htlabnet/Arduino_DRSSTC_Interrupter_For_v1/README.md

# HTLAB.NET Arduino DRSSTC Interrupter

https://htlab.net/electronics/teslacoil/arduino-drsstc-interrupter/
