htlabnet/Arduino_DRSSTC_Interrupter_For_v1/(list of files, cad)

Other CAD files:
Design/Arduino_Interrupter_v1_Design.dwg
Design/Arduino_Interrupter_v1_TD10-15-4_Connector_MIDI_USB.dwg
Design/TD10-15-4.dxf
Design/Arduino_Interrupter_v1_TD10-15-4_Top.dwg
Design/Arduino_Interrupter_v1_TD10-15-4_Connector_BNC.dwg
Design/TD10-15-4.dwg
