htlabnet/Arduino_DRSSTC_Interrupter_For_v1/Document/Arduino_DRSSTC_Interrupter_Ver1.0_Schematic.pdf

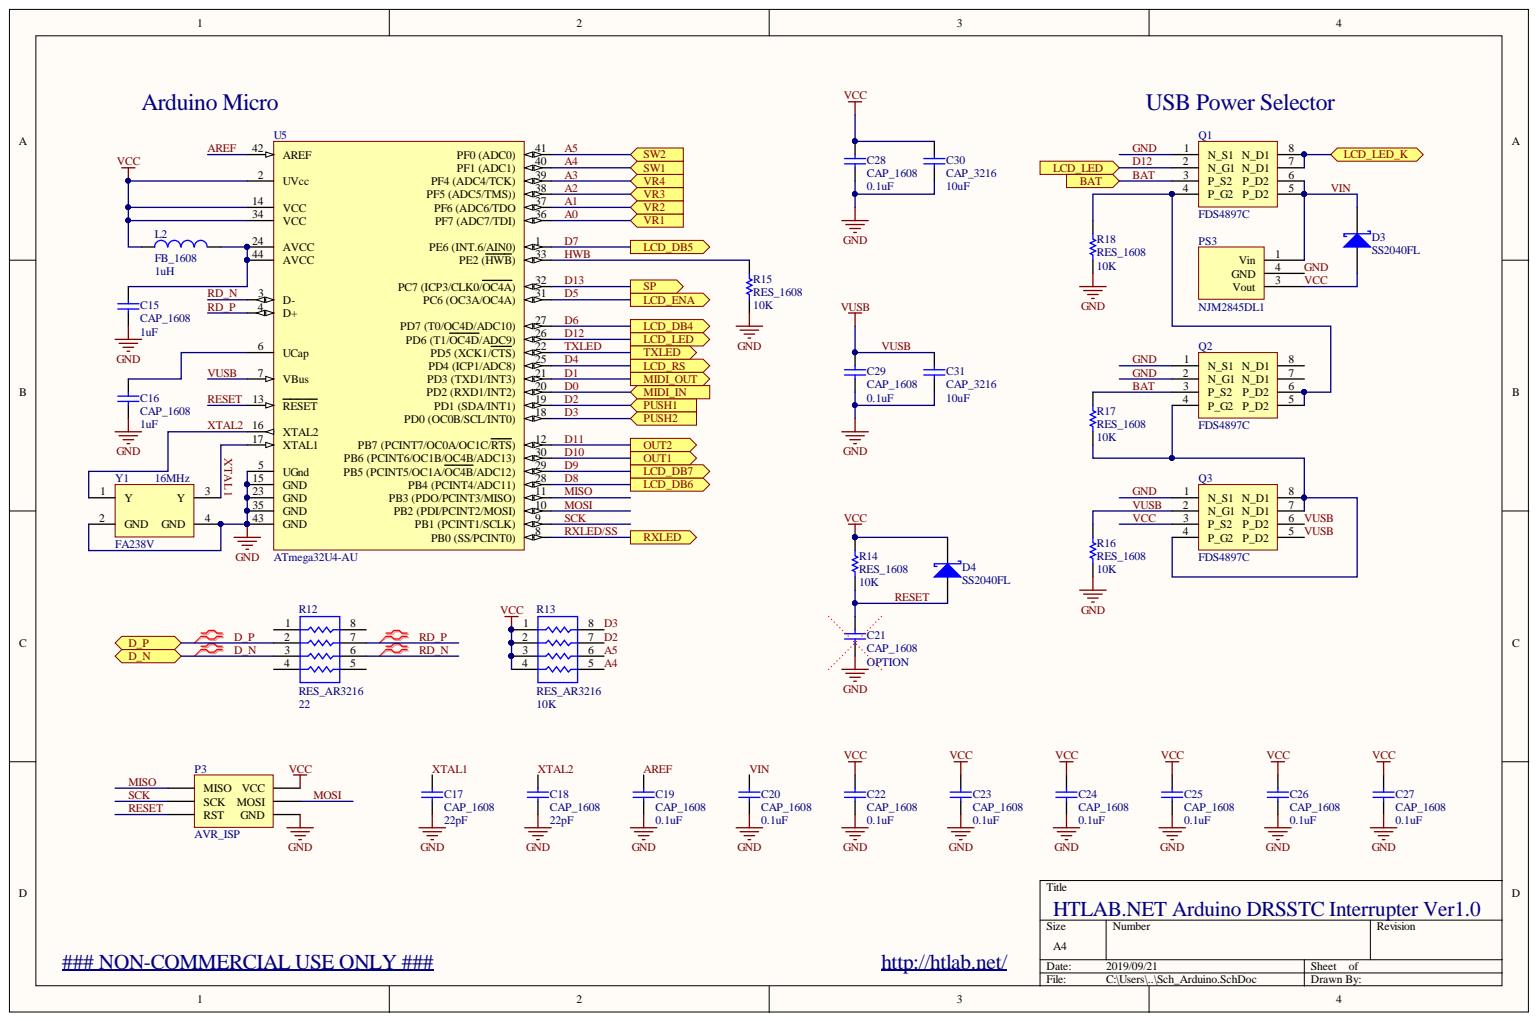
[picture p35: page 1]

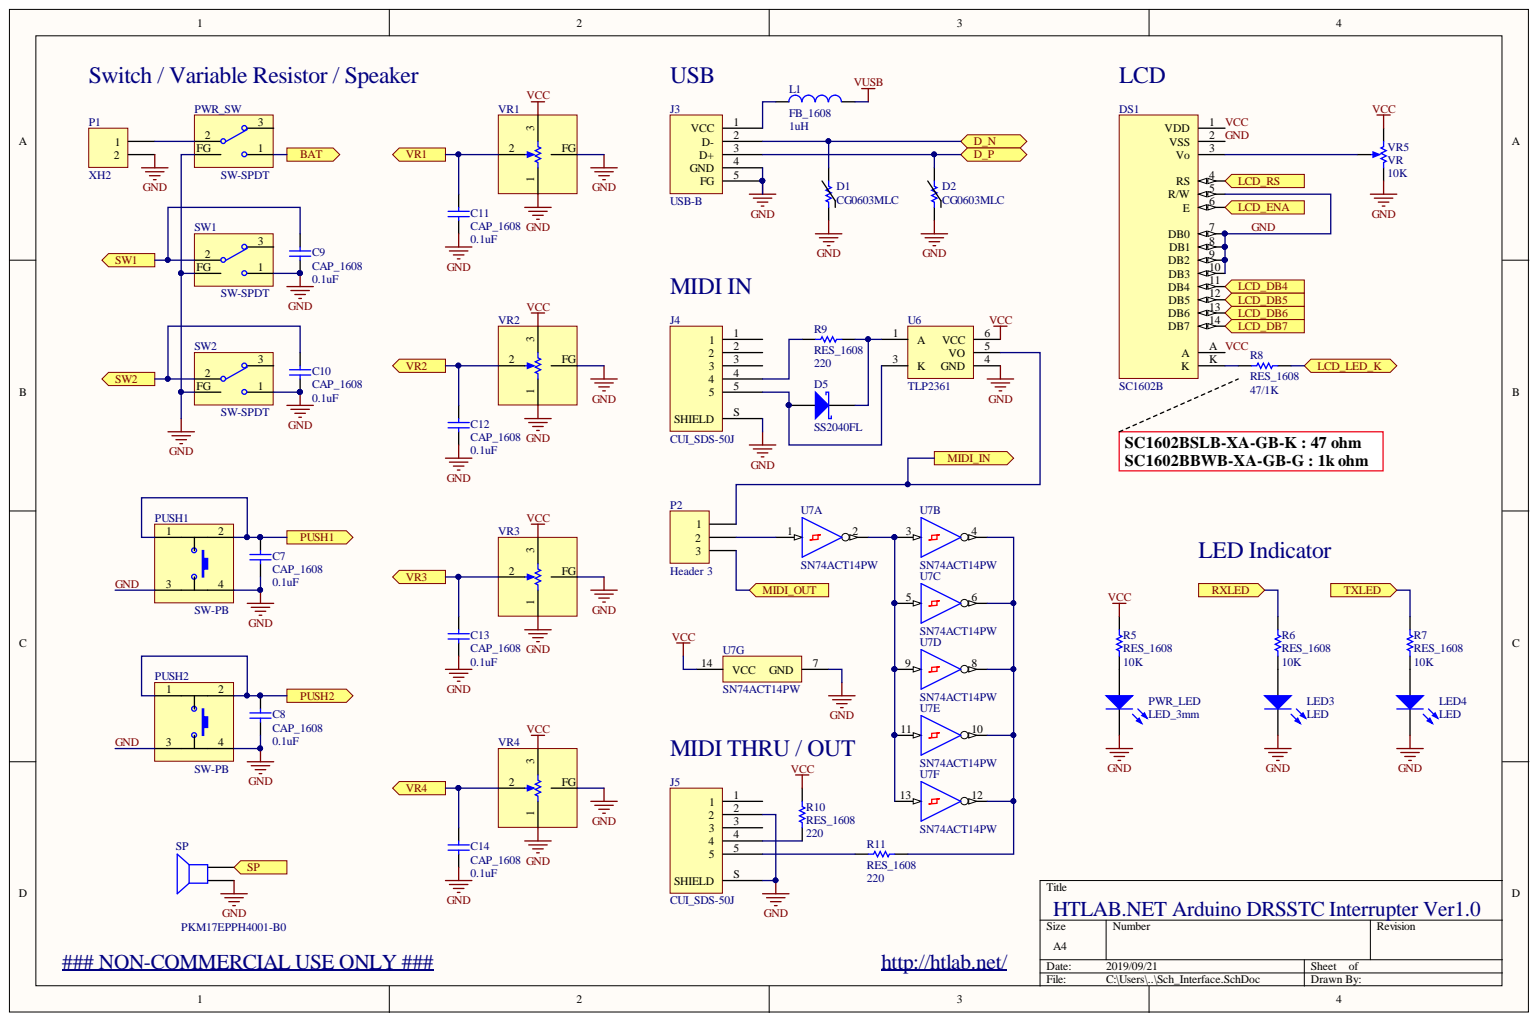
[picture p36: page 2]

GND GND

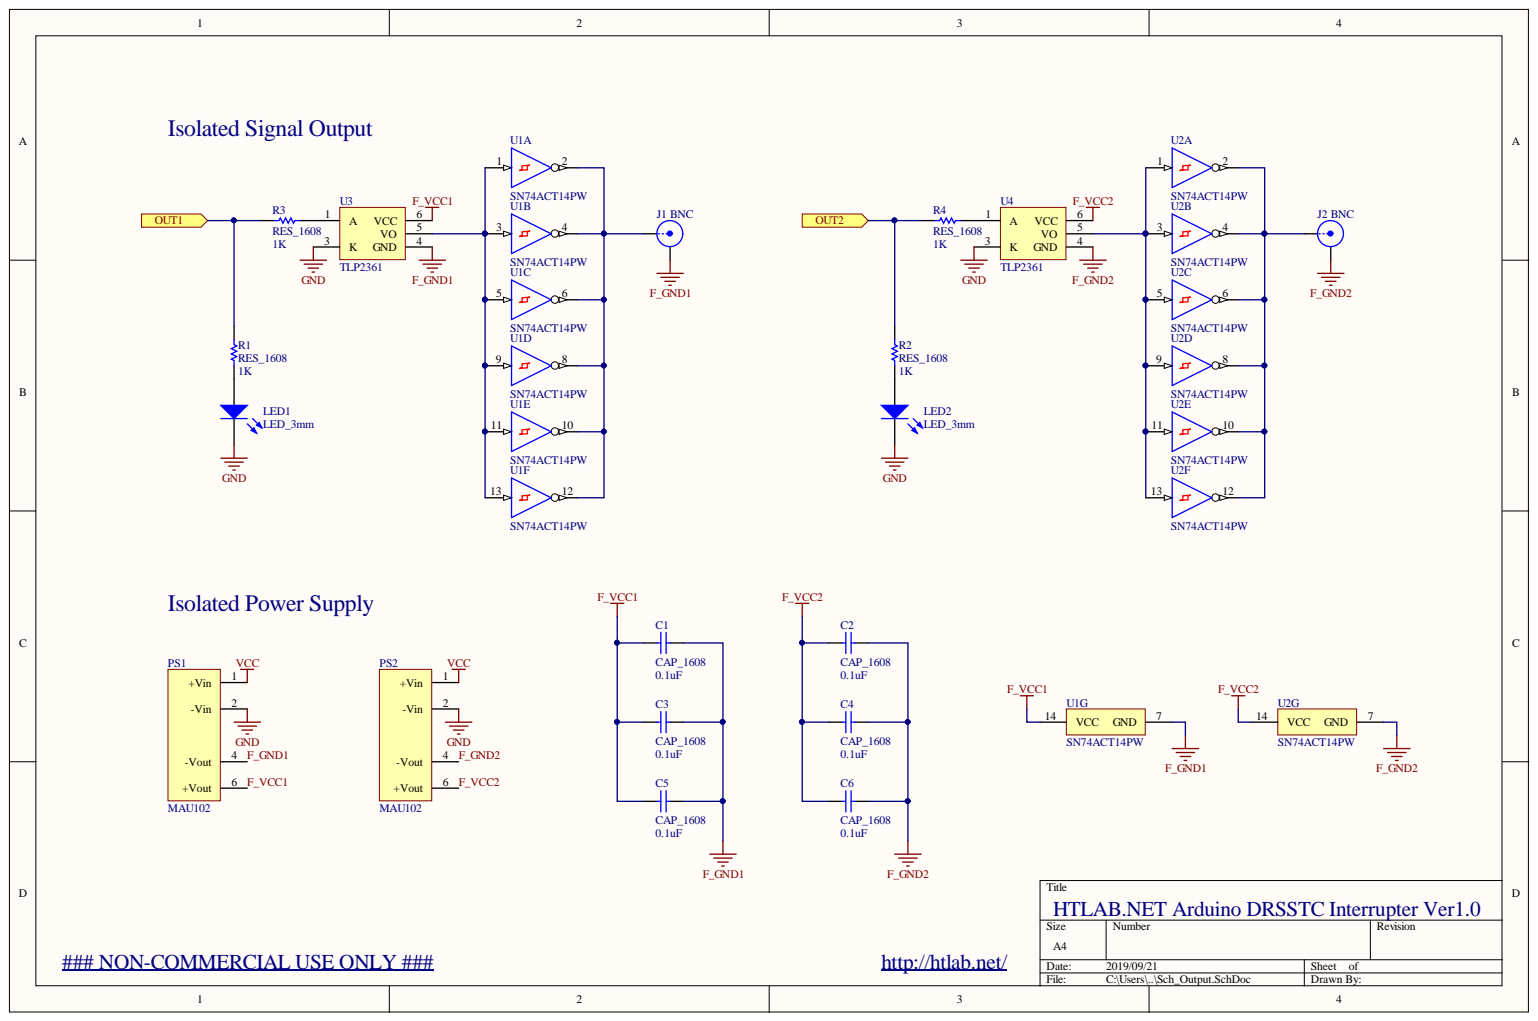
[picture p37: page 3]

Title
HTLAB.NET Arduino DRSSTC Interrupter Ver1.0

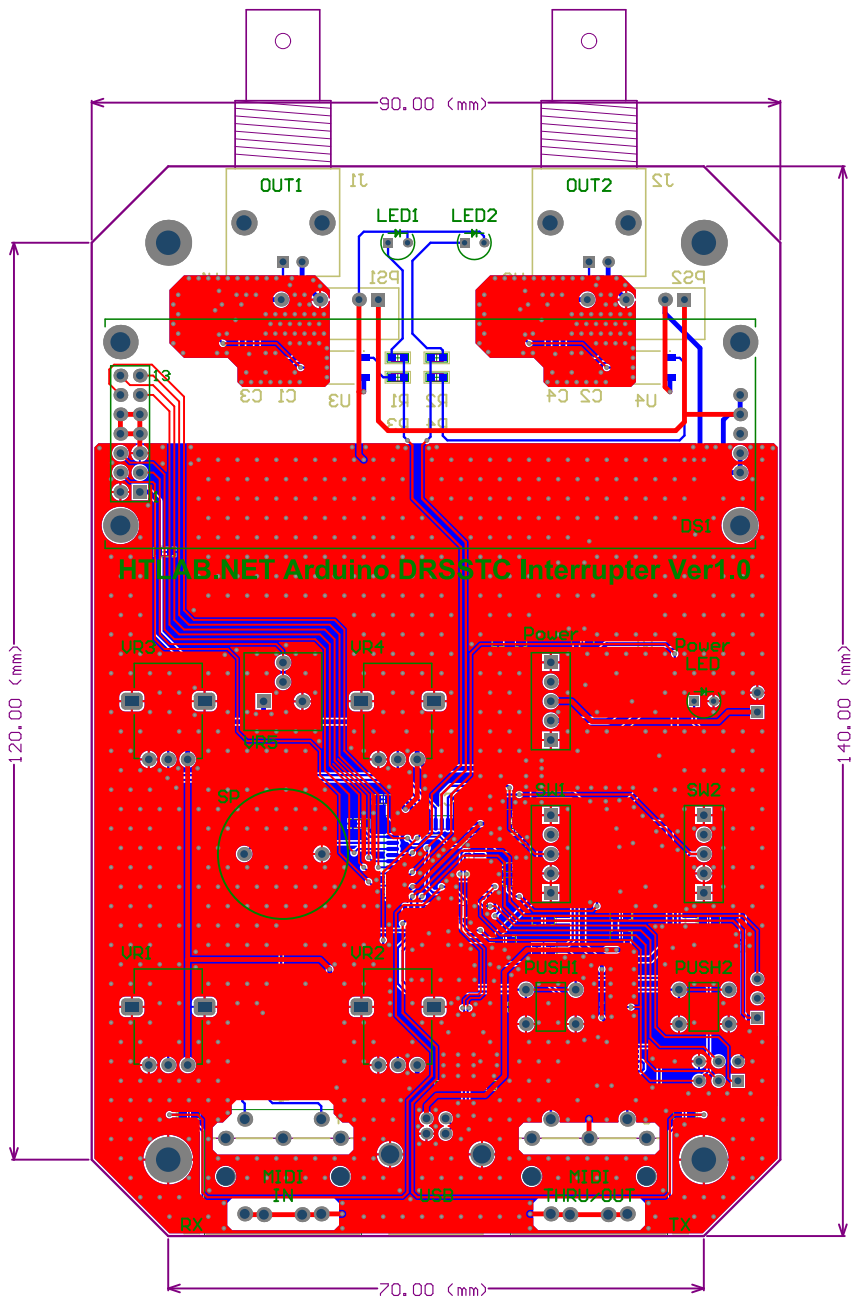
[picture p38: page 4]
