htlabnet/Arduino_DRSSTC_Interrupter_For_v1/Firmware/HTLAB.NET_Arduino_DRSSTC_Interrupter/lib_midi.h

#ifndef LIB_MIDI_H
#define LIB_MIDI_H

#include "settings.h"

// MIDI Note Number to Frequency
#if OSC_TIMER_DIVIDER == 8
  static float note_to_hz[128] = {32.7032,34.6478,36.7081,38.8909,41.2034,43.6535,46.2493,48.9994,51.9131,55,58.2705,61.7354,32.7032,34.6478,36.7081,38.8909,41.2034,43.6535,46.2493,48.9994,51.9131,55,58.2705,61.7354,32.7032,34.6478,36.7081,38.8909,41.2034,43.6535,46.2493,48.9994,51.9131,55,58.2705,61.7354,65.4064,69.2957,73.4162,77.7817,82.4069,87.3071,92.4986,97.9989,103.8262,110,116.5409,123.4708,130.8128,138.5913,146.8324,155.5635,164.8138,174.6141,184.9972,195.9977,207.6523,220,233.0819,246.9417,261.6256,277.1826,293.6648,311.127,329.6276,349.2282,369.9944,391.9954,415.3047,440,466.1638,493.8833,523.2511,554.3653,587.3295,622.254,659.2551,698.4565,739.9888,783.9909,830.6094,880,932.3275,987.7666,1046.5023,1108.7305,1174.6591,1244.5079,1318.5102,1396.9129,1479.9777,1567.9817,1661.2188,1760,1864.655,1975.5332,2093.0045,2217.461,2349.3181,2489.0159,2637.0205,2793.8259,2959.9554,3135.9635,3322.4376,3520,3729.3101,3951.0664,4186.009,4434.9221,4698.6363,4978.0317,5274.0409,5587.6517,5919.9108,6271.927,6644.8752,7040,7458.6202,7902.1328,8372.0181,8869.8442,9397.2726,9956.0635,10548.0818,11175.3034,11839.8215,12543.854};
#elif OSC_TIMER_DIVIDER == 64
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
#endif


#endif
