htlabnet/Arduino_DRSSTC_Interrupter_For_v1/Firmware/HTLAB.NET_Arduino_DRSSTC_Interrupter/lib_output.cpp

#include "lib_output.h"

void output_init() {

  // Pin Settings
  pinMode(10, OUTPUT);
  pinMode(11, OUTPUT);
  pinMode(12, OUTPUT);
  pinMode(13, OUTPUT);

  // LCD Backlight
  digitalWrite(12, HIGH);

}


void output_single_pulse(uint8_t pin, uint16_t ontime) {

  // Arduino Leonardo, Micro (ATmega32u4)
  // D10-11 = PB6-7
  PORTB |= _BV(pin + 6);
  if (beep_active) PORTC |= _BV(7);
  __asm__("nop\n\t");
  __asm__("nop\n\t");
  __asm__("nop\n\t");
  __asm__("nop\n\t");
  delayMicroseconds(ontime);
  PORTB &= ~_BV(pin + 6);
  if (beep_active) PORTC &= ~_BV(7);

}


void output_dual_pulse(uint16_t ontime) {

  // Arduino Leonardo, Micro (ATmega32u4)
  // D10-11 = PB6-7
  PORTB |= _BV(6) | _BV(7);
  if (beep_active) PORTC |= _BV(7);
  __asm__("nop\n\t");
  __asm__("nop\n\t");
  __asm__("nop\n\t");
  __asm__("nop\n\t");
  delayMicroseconds(ontime);
  PORTB &= ~(_BV(6) | _BV(7));
  if (beep_active) PORTC &= ~_BV(7);

}
