htlabnet/Arduino_DRSSTC_Interrupter_For_v1/(commit log)

2019-01-24 change output pin, reduce support board
2019-01-26 Added "One Shot Mode" & "High Power Mode"
2019-04-19 Fix osc and burst mode
    [HTLAB.NET_Arduino_DRSSTC_Interrupter.ino, lib_osc.cpp, lib_osc.h]
2019-05-09 MIDI Mode bug fix
    [HTLAB.NET_Arduino_DRSSTC_Interrupter.ino, lib_input.cpp, settings.h]
2019-09-05 add design file
    [Arduino_Interrupter_v1_TD10-15-4_Connector_BNC.dwg, Arduino_Interrupter_v1_TD10-15-4_Connector_MIDI_USB.dwg, Arduino_Interrupter_v1_TD10-15-4_Top.dwg, TD10-15-4.dwg, TD10-15-4.dxf]
2019-11-01 MIDI mono mode fix
    [HTLAB.NET_Arduino_DRSSTC_Interrupter.ino, settings.h]
2019-12-07 Add MIDI FIXED Mode
    [HTLAB.NET_Arduino_DRSSTC_Interrupter.ino, lib_input.cpp, settings.h]
2019-12-10 Edit Pin Assign
2019-12-10 Add Design Files
    [Arduino_Interrupter_v1_Design.dwg]
2020-12-08 add BOM
    [Arduino_DRSSTC_Interrupter_Ver1.0_BOM.csv]
2020-12-08 add schematic
2020-12-08 add gerber
